seblovett/cartrack/README.md

cartrack
========

A car tracking system using GPS and GSM

Current Capabilities
====================

The GSM has been prototyped and proven to work. 

PCB is V1.0 and not been made nor tested.
