seblovett/cartrack/Specification/spec.pdf

# Car Track Specification

### Henry Lovett, Sam Hooper

### 19th April, 2014

## 1 Introduction

This project is about creating a module capable of remotely tracking a car. The module is capable of acquiring and reporting a location to a website.

## 2 Specification

The following are the main goals:

1. Be able to report the location of the car to a website.
2. Website shows past and current location of the car.
3. Hardware device uses GPS to acquire location and GSM to send data to a website.
4. Hardware must be able to send data irrespective of whether the car is running.
5. Hardware is capable of being configured by a user via the website.

## 3 Hardware Device

The hardware is to be a module with a GPS and GSM modem. It is to be powered by the car battery. LiPo battery could be used, but the current draw should be low enough to not impact the main battery. It will be concealed in the car.

1

### 3.1 Specification

1. Device should be able to acquire location to within an acceptable ac-curacy
2. Device can send data over an internet GSM connection
3. Module should have a distance threshold. Once the threshold is passed, the new location is reported.
4. During sleep mode, GSM should be disabled to save battery. Website should be polled to check for option updates. GPS should be polled to check the car hasn’t moved.
5. Device should report to website when low on credit (if PAYG SIM card is used)

### 3.2 Costings

The below is an approximate costings for one module.

Item | Quantity Cost (£)
Qualtec M10 GSM | 1 | 15.00
MTK3339 GPS | 1 | 10.00
Atmega 644P QFP | 1 | 6.00
PCB (10cm by 10cm) | 10 | 20.00
Other passives | N/A | 5.00
TOTAL | 1 | 56
TOTAL | 2 | 87

## 4 Website

Website should be able to show the locations for a car. Log in and user should be supported. A module should be able to be configured with options. A “My Car Is Stolen” button could be implemented to heighten the sleep poll rate. Be able to send an alert if the credit is low.

2

## 5 Interface

“Sending” data is the moving of information from the module to the server. “Receiving” data is the moving of information from the server to the module.

### 5.1 Sending Data

A webpage will be used to send data to via a query string. The query string
should be of the form:

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

The interface.php webpage should report “OK” if the query string is well
formed and the UID is recognised. Else, “ER” should be returned. The text
should be plain text and not HTML formatted. Credit reporting is optional.

### 5.2 Receiving Data

A webpage will be used to configure the device. The page will be accessed with a query string of the device as follows:

www. u r l . co . uk/ o p ti o n s . php? uid=01

The page should look up the configuration from a database and return plain text in the following format:

OPTION=1

For example:

WAKE PERIOD=2
SLEEP PERIOD=60
MOVE THRESH=100

Exact option names and units of the values are TBC.

3
