seblovett/cartrack/PCB/Design/bom.ods

Value | Device | Package | Qty | Cost per Unit (£) | Purchase Quantity | Cost Per Board | Store
GPS_FGPMMOPA6H | FGPMMOPA6H | U2 | 1 | 15.02 | 1 | 15.02 | http://www.aliexpress.com/store/product/FGPMMOPA6H-utilizes-the-MediaTek-new-generation-GPS-Chipset-MT3339/605000_623742154.html
LEDSML0603 | SML0603 | LED1 | 1 | 0 | 1 | 0 | STOCK
M03X2NO_SILK | 2X3-NS | SPI, | 2 | 0 | 1 | 0 | STOCK
NPN-TRANSISTOR_SOT23W | SOT23W | Q1, | 3 | 0.32 | 1 | 0.96 | Mouser
10k | R-EU_R0603 | R0603 | 1 | 0 | 1 | 0 | STOCK
12MHz | CRYSTALSM49 | SM49 | 1 | 0 | 1 | 0 | STOCK
22pF | CAP0603-CAP | 0603-CAP | 2 | 0 | 1 | 0 | STOCK
470nF | C-EU025-024X044 | C025-024X044 | 1 | 0 | 1 | 0 | STOCK
ATMEGA644P-20AU | ATMEGA644P-20AU | QFP80P1200X1200X120-44N | 1 | 5 | 1 | 5 | Mouser
LM2941 | LM2941 | LM2941 | 1 | 1.16 | 1 | 1.16 | Mouser
M05X2PTH | M05X2PTH | AVR_ICSP | 1 | 0 | 1 | 0 | STOCK
POWER_JACKPTH | POWER_JACKPTH | POWER_JACK_PTH | 1 | 0.78 | 1 | 0.78 | Mouser
QUECTELM10 | QUECTELM10 | QUECTELM10 | 1 | 17.7 | 1 | 17.7 | http://www.aliexpress.com/item/1pcs-Quectel-M10-module-with-MMS-protocol/1307862112.html
SIMHOLDER | SIMHOLDER | SIMHOLDER | 1 | 1.62 | 1 | 1.62 | Mouser
SMF05C | SMF05C | SC-88 | 1 | 0.37 | 1 | 0.37 | Mouser
SWITCH-MOMENTARY-2PTH | SWITCH-MOMENTARY-2PTH | TACTILE-PTH | 1 | 0 | 1 | 0 | STOCK
PCB |  |  | 1 | 11.72 | 10 | 11.72 | IteadStudio
Antenna |  |  | 1 | 6.59 | 1 | 6.59 | Mouser
SMA Connector |  |  | 1 | 3.04 | 1 | 3.04 | Mouser
Shipping | Mouser |  |  |  |  | 12
 |  | Number to make | 1
 |  | Cost per Board (not including shipping) | 75.96
