seblovett/cartrack/PCB/Design/cartrack.brd

## EAGLE design PCB/Design/cartrack.brd (2014-07-22)

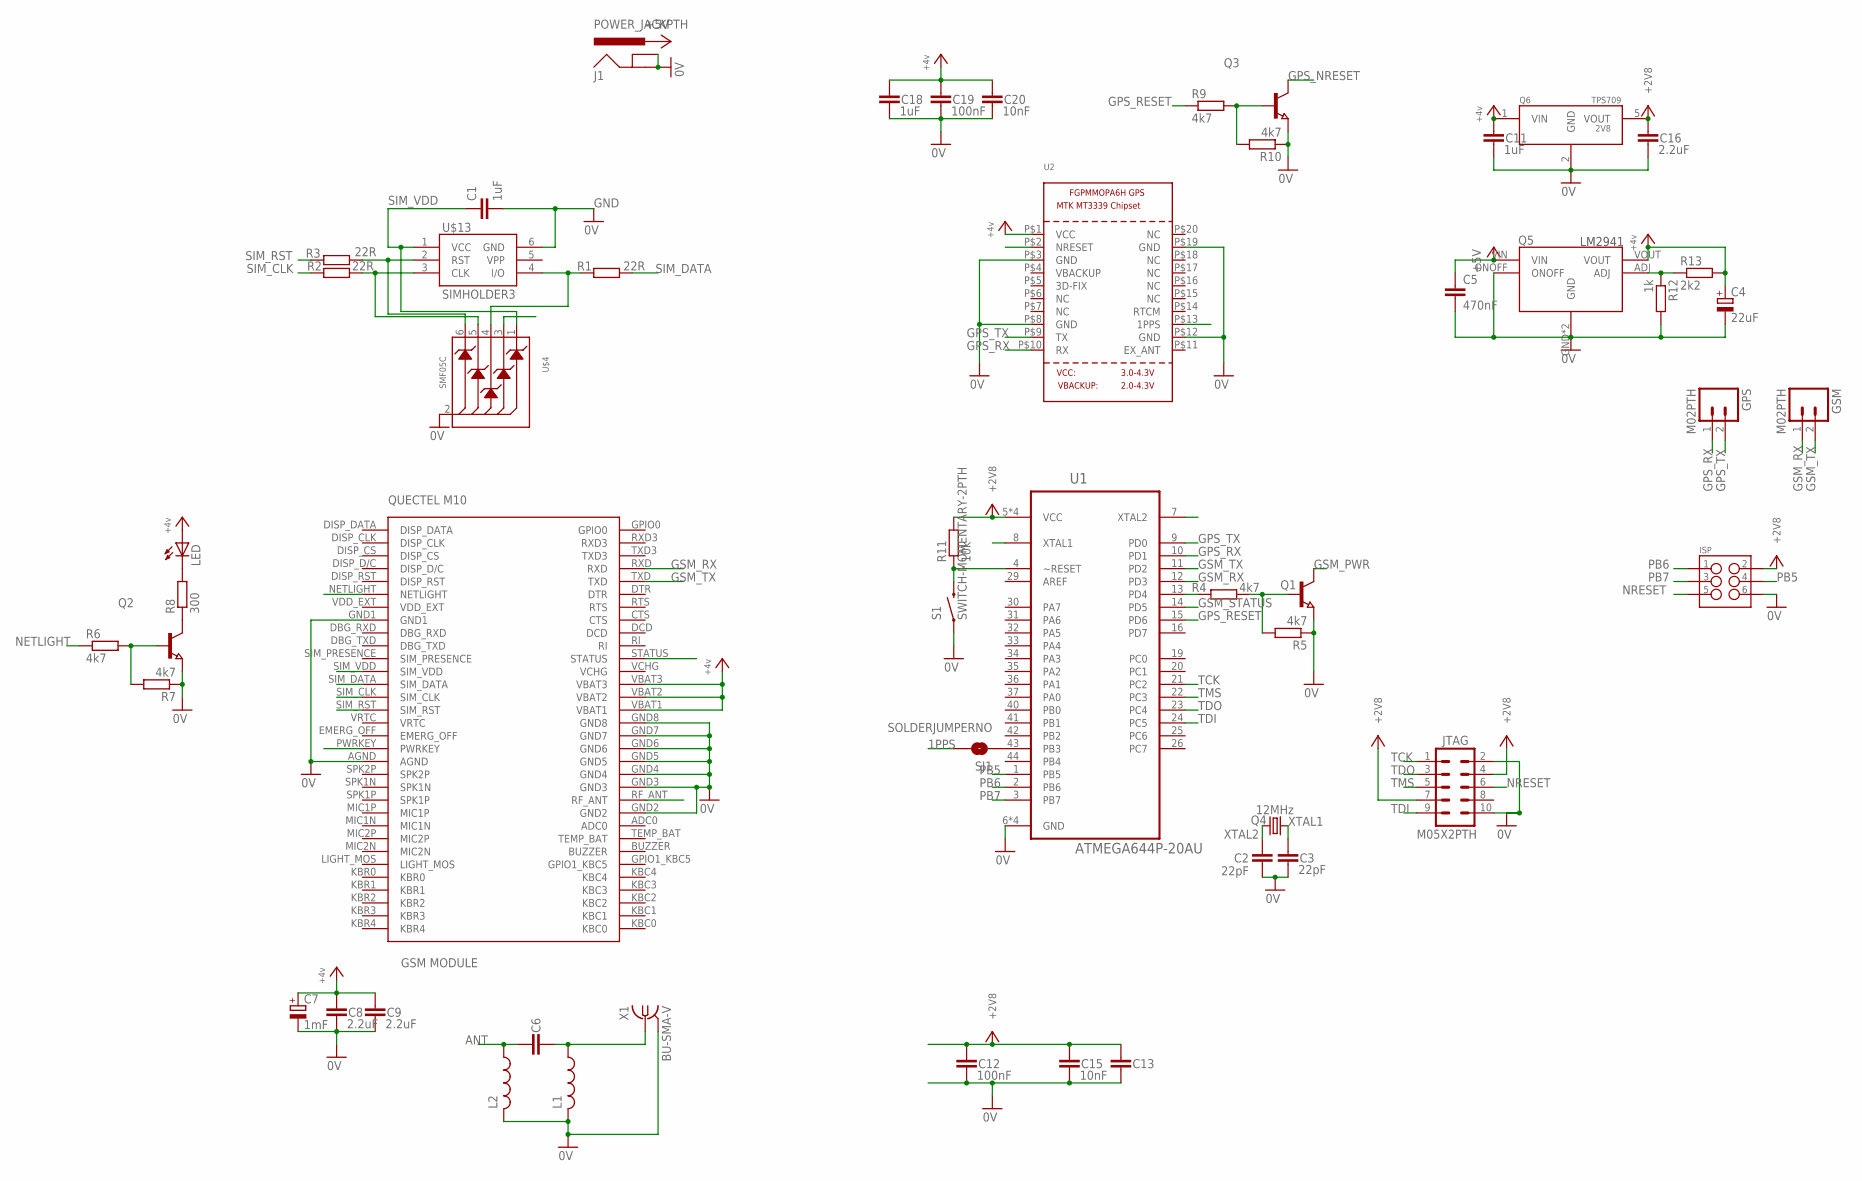
[picture p1: schematic cartrack.sch]

Parts:
C1: 1uF; C0603
C2, C3: 22pF; 0603-CAP
C4: 22uF; E3,5-8
C5: 470nF; C025-024X044
C6, C13: CAP0603-CAP; 0603-CAP
C7: 1mF; E3,5-8
C8, C9, C16: 2.2uF; 1206
C11: 1uF; 1206
C12, C19: 100nF; 1206
C15, C20: 10nF; 0603-CAP
C18: 1uF; CAP-PTH-SMALL
GPS: M02PTH; 1X02
GSM: M02PTH; 1X02
ISP: M03X2NO_SILK; 2X3-NS
J1: POWER_JACKPTH; POWER_JACK_PTH
JTAG: M05X2PTH; AVR_ICSP
L1, L2: L-USL2012C; L2012C
LED: LEDSML0603; SML0603
Q1, Q2, Q3: NPN-TRANSISTOR_SOT23W; SOT23W
Q4: 12MHz; SM49
Q5: LM2941
Q6: TPS70928; SOT23-5
R1, R2, R3: 22R; R0603
R4, R5, R6, R7, R9, R10: 4k7; R0603
R8: 300; R0603
R11: 10k; R0603
R12: 1k; R0603
R13: 2k2; R0603
S1: SWITCH-MOMENTARY-2PTH; TACTILE-PTH
SJ1: SOLDERJUMPERNO; SJ_2S-NO
U1: ATMEGA644P-20AU; QFP80P1200X1200X120-44N
U2: GPS_FGPMMOPA6H; FGPMMOPA6H
U$1: QUECTELM10
U$4: SMF05C; SC-88
U$13: SIMHOLDER3
X1: BU-SMA-V

Connections:
1PPS: SJ1.2, U2.P$13 (1PPS)
+2V8: C12.1, C13.1, C15.1, C16.1, ISP.2, JTAG.4, JTAG.7, Q6.5 (VOUT), R11.2, U1.5 (VCC), U1.17 (VCC), U1.27 (VCC), U1.38 (VCC)
+4V: C4.+, C7.+, C8.1, C9.1, C11.1, C18.1, C19.1, C20.1, LED.A, Q5.VOUT, Q6.1 (VIN), R13.2, U2.P$1 (VCC), U$1.VBAT1, U$1.VBAT2, U$1.VBAT3
+5V: C5.1, J1.PWR, Q5.VIN
ANT: C6.1, L2.1, U$1.RF_ANT
ANT_1: C6.2, L1.1, X1.1
GND: C1.2, C2.2, C3.2, C4.-, C5.2, C7.-, C8.2, C9.2, C11.2, C12.2, C13.2, C15.2, C16.2, C18.2, C19.2, C20.2, ISP.6, J1.GND, J1.GNDBREAK, JTAG.2, JTAG.10, L1.2, L2.2, Q1.3 (E), Q2.3 (E), Q3.3 (E), Q5.GND, Q5.ONOFF, Q5.TAB (GND), Q6.2 (GND), R5.1, R7.1, R10.1, R12.2, S1.1, U2.P$3 (GND), U2.P$8 (GND), U2.P$12 (GND), U2.P$19 (GND), U$1.AGND, U$1.GND1, U$1.GND2, U$1.GND3, U$1.GND4, U$1.GND5, U$1.GND6, U$1.GND7, U$1.GND8, U$4.2 (ANODE), U$13.6 (GND), X1.2, X1.3 (2), X1.4 (2), X1.5 (2)
GPS_NRESET: Q3.2 (C), U2.P$2 (NRESET)
GPS_RESET: R9.1, U1.15 (PD6)
GPS_RX: GPS.1, U1.10 (PD1), U2.P$10 (RX)
GPS_TX: GPS.2, U1.9 (PD0), U2.P$9 (TX)
GSM_PWR: Q1.2 (C), U$1.PWRKEY, U$4.3 (CATODE2)
GSM_RX: GSM.1, U1.12 (PD3), U$1.RXD
GSM_STATUS: U1.14 (PD5), U$1.STATUS
GSM_TX: GSM.2, U1.11 (PD2), U$1.TXD
unnamed: Q1.1 (B), R4.2, R5.2
unnamed: R4.1, U1.13 (PD4)
unnamed: Q5.ADJ, R12.1, R13.1
unnamed: Q2.1 (B), R6.2, R7.2
unnamed: Q2.2 (C), R8.1
unnamed: LED.C, R8.2
unnamed: Q3.1 (B), R9.2, R10.2
unnamed: SJ1.1, U1.43 (PB3)
NETLIGHT: R6.1, U$1.NETLIGHT
NRESET: ISP.5, JTAG.6, R11.1, S1.3 (2), U1.4 (~RESET)
PB5: ISP.4, U1.1 (PB5)
PB6: ISP.1, U1.2 (PB6)
PB7: ISP.3, U1.3 (PB7)
SIM_CLK: R2.1, U$1.SIM_CLK
SIM_CLK_R: R2.2, U$4.5 (CATODE4), U$13.3 (CLK)
SIM_DATA: R1.2, U$1.SIM_DATA
SIM_DATA_R: R1.1, U$4.4 (CATODE3), U$13.4 (I/O)
SIM_RST: R3.1, U$1.SIM_RST
SIM_RST_R: R3.2, U$4.6 (CATODE5), U$13.2 (RST)
SIM_VDD: C1.1, U$1.SIM_VDD, U$4.1 (CATODE1), U$13.1 (VCC)
TCK: JTAG.1, U1.21 (PC2)
TDI: JTAG.9, U1.24 (PC5)
TDO: JTAG.3, U1.23 (PC4)
TMS: JTAG.5, U1.22 (PC3)
XTAL1: C3.1, Q4.2, U1.8 (XTAL1)
XTAL2: C2.1, Q4.1, U1.7 (XTAL2)

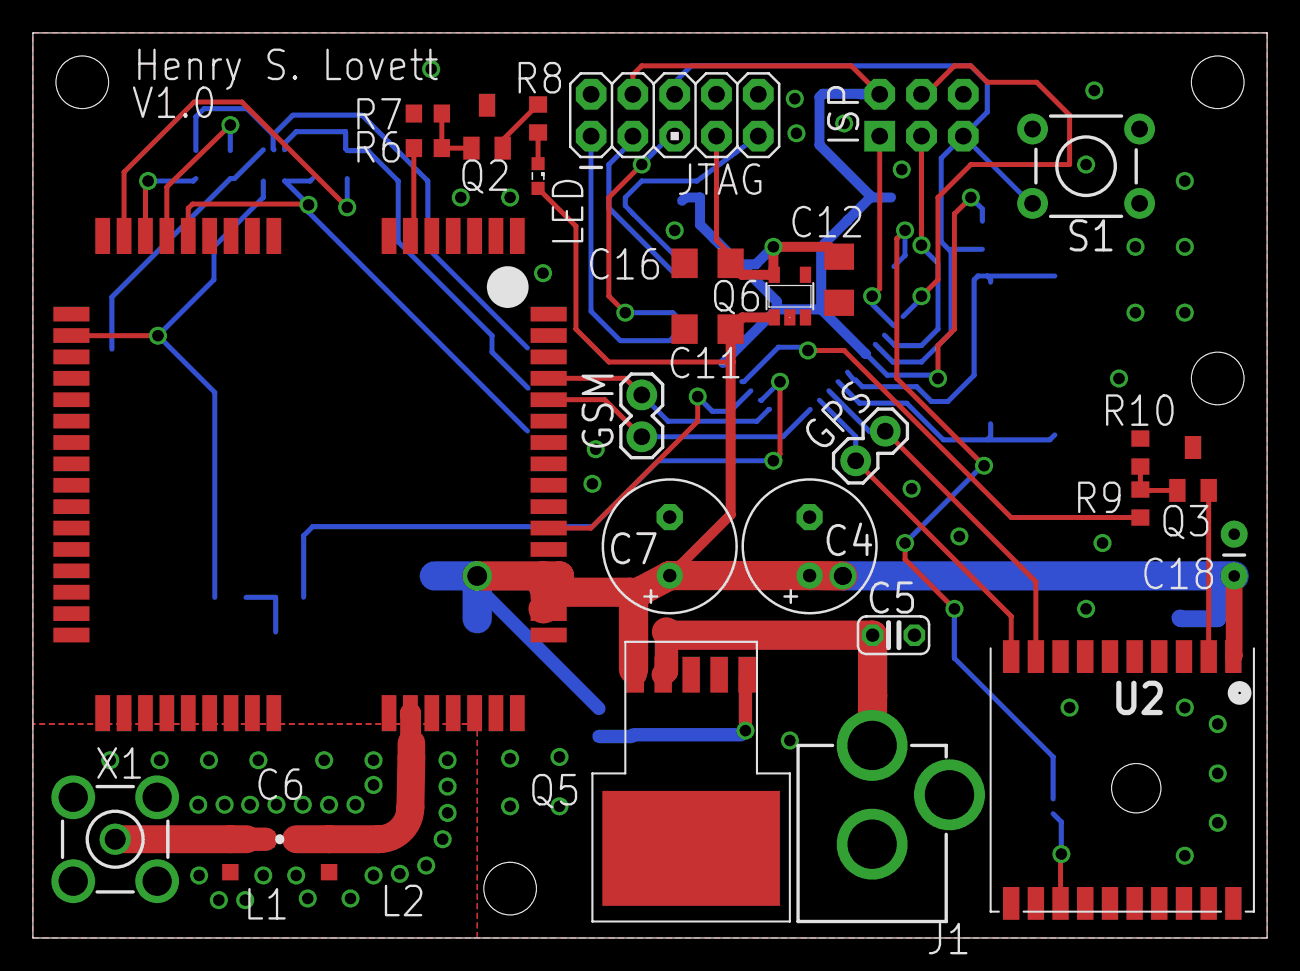
[picture p2: board cartrack.brd from above]

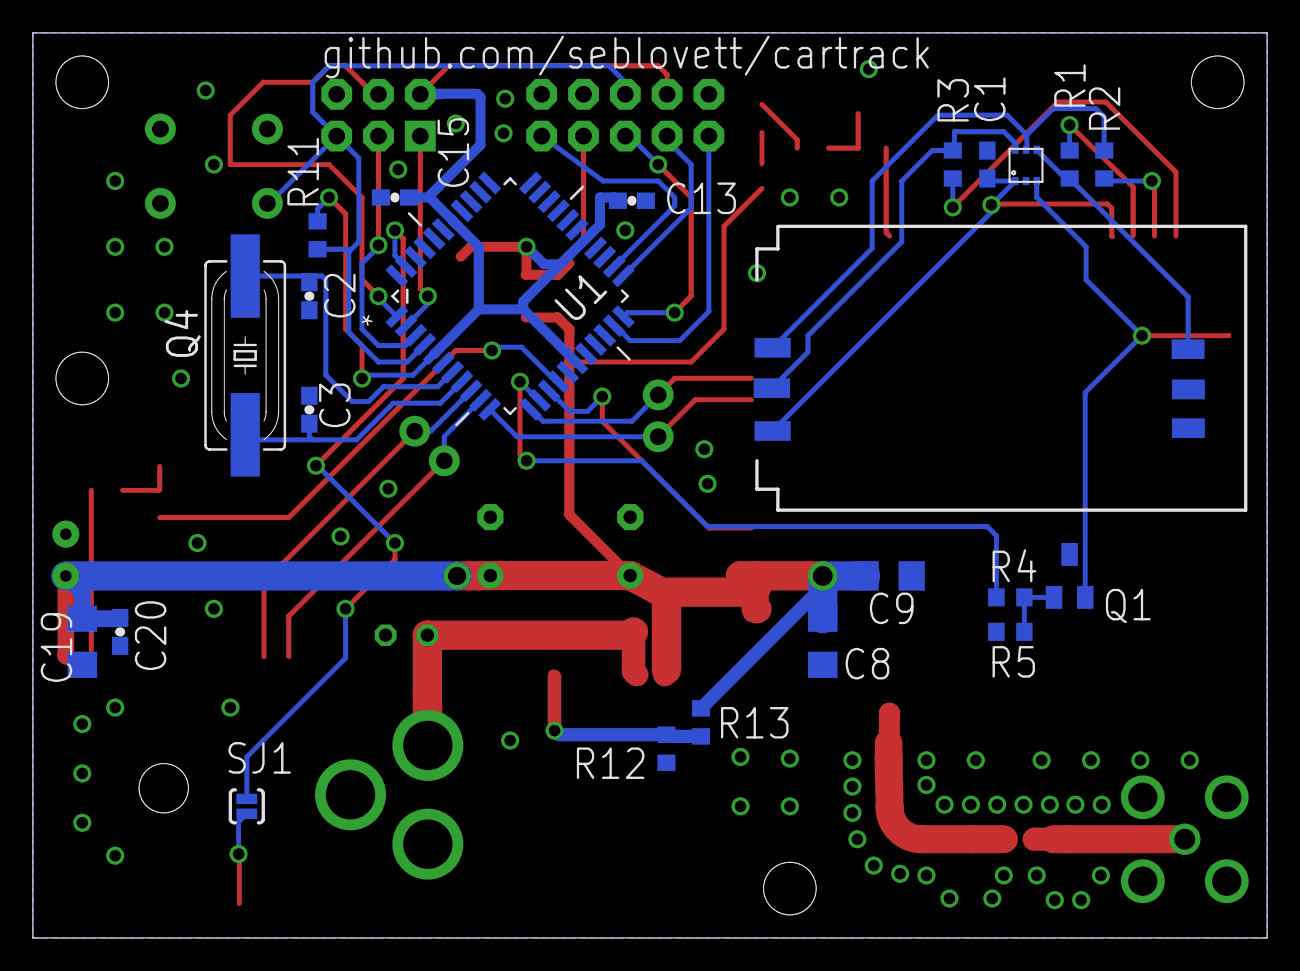
[picture p3: board cartrack.brd from below]

Board: 2 copper layers, 75.0 x 55.0 mm, 52 parts (23 on the bottom side), 41 nets.
