seblovett/cartrack/(commit log)

2014-04-19 Started the PCB schematic and design.
    [cartrack.brd, cartrack.sch]
2014-06-15 Got basic printf working.
2014-06-15 Got AT OK working.
    Timeout implemented. Will power on the GSM also
2014-06-16 Done most of the GSM schematic.
    Power and GPS remain
    [cartrack.brd, cartrack.sch]
2014-06-16 Added GPS to schematic. Need to do power
    [cartrack.brd, cartrack.sch]
2014-06-16 Added all major components to schematic.
    Need to do the antenna, decoupling capacitors and layout
    [cartrack.brd, cartrack.sch]
2014-06-16 added to do list to schematic
    [cartrack.sch]
2014-06-16 Added Bill of Materials
    [bom.csv, bom.ods]
2014-06-17 Finished schematic.
    Started on PCB.
    [cartrack.brd, cartrack.sch]
2014-06-17 Corrected some errors in the library.
    Keepout in the M10 - stops ground planes. Removed the via layer too
    Polygon width to satisy the DRC
2014-06-17 First draft of the PCB
    [cartrack.brd, cartrack.sch]
2014-06-18 Redone the PCB layout. Corrected mask and pad errors in the libraries
    [cartrack.brd, cartrack.sch]
2014-06-18 Some changes to the antenna
    [cartrack.brd]
2014-07-22 I can't remember what I have done... but it was probably important.
    [bom.ods, cartrack.brd]
